jstaffel/tinyLoRaHW/README.md

# tinyLoRaHW
Hardware files of the tinyLoRa, a board that uses Rapsberry Pi's RP2040 microcontroller for LoRaWAN communication.
The board was designed in KiCad
