jstaffel/tinyLoRaHW/tinyLoRa/BOM_tinyLoRa_v1.01.xlsx

tinyLoRa |  |  | BOM |  |  | v1.01
 |  |  |  |  |  | 2022-06-06
RefDes | MPN | Geometry | Value | Qty | Description | Manufacturer
IC
U1 | MCP73831-5ACI_MC | - | - | 1 | Battery Management Li-Ion/Li-Poly Charg Mgnt 4.5V Vreg out | Microchip
U2 | SX1261IMLTRT | - | - | 1 | RF Transceiver LoRa, Low Power sub- GHz RF Transceiver | SEMTECH
U3 | AS213-92LF | - | - | 1 | SKYWORKS SOLUTIONS - AS213-92LF - IC, SWITCH, RF, SPDT, 0.1-3.0GHZ | Skyworks
U4 | AP2112M-3.3TRG1 | - | - | 1 | LDO Voltage Regulators LDO CMOS HiCurr | Diodes Inc.
U5 | W25Q128JVSIM | - | - | 1 | NOR-Flash spiFlash, 3V, 128M-bit, 4Kb Uniform Sector, DTR | Winbond
U6 | RPI Chip RP2040-7-500 | - | - | 1 | Dual ARM Cortex M0+ Microcontroller | Raspberry Pi
Resistors
R1 | - | 0603_1608 | 470 | 1 | - | -
R2 | - | 0603_1608 | 5k1 | 1 | - | -
R3 | - | 0603_1608 | 100 | 1 | - | -
R4 | CMP0603AFX-27R0ELF | 0603_1608 | 27 | 1 | Thick Film Resistors ResHighPowerA 0603 27R 1% 1/4W TC100 | Bourns
R5 | - | 0603_1608 | 10k | 1 | - | -
R6 | CMP0603AFX-27R0ELF | 0603_1608 | 27 | 1 | Thick Film Resistors ResHighPowerA 0603 27R 1% 1/4W TC100 | Bourns
R7 | - | 0603_1608 | 100 | 1 | - | -
R8 | - | 0603_1608 | DNP | 1 | - | -
R9 | - | 0603_1608 | DNP | 1 | - | -
R10 | - | 0603_1608 | 1k | 1 | - | -
R11 | ERJ-UP3F2000V | 0603_1608 | 200 | 1 | Thick Film Resistors 0603 0.25W 1% 200ohm AEC-Q200 | Panasonic
R12 | ERJ-U03F1R00V | 0603_1608 | 1 | 1 | Thick Film Resistors 0603 1% 1ohm AEC-Q200 Anti-Sulfur | Panasonic
R13 | - | 0603_1608 | 390 | 1 | - | -
R14 | - | 0603_1608 | 10k | 1 | - | -
R15 | - | 0603_1608 | DNP | 1 | - | -
R16 | - | 0603_1608 | 1k | 1 | - | -
Capacitors
C1 | - | 0603_1608 | DNP | 1 | - | -
C2 | - | 0603_1608 | DNP | 1 | - | -
C3 | ZRB18AR6YA475KE05L | 0603_1608 | 4u7 | 1 | Multilayer Ceramic Capacitors MLCC - SMD/SMT | Murata Electronics
C4 | ZRB18AR6YA475KE05L | 0603_1608 | 4u7 | 1 | Multilayer Ceramic Capacitors MLCC - SMD/SMT | Murata Electronics
C5 | - | 0603_1608 | 10n | 1 | - | -
C6 | GRM1555C1H3R0BA01D | 0402_1005 | 3p | 1 | Multilayer Ceramic Capacitors MLCC - SMD/SMT | Murata Electronics
C7 | - | 0603_1608 | 1n | 1 | - | -
C8 | - | 0603_1608 | 1u | 1 | - | -
C9 | GRM1555C1H120JA01J | 0402_1005 | 12p | 1 | Multilayer Ceramic Capacitors MLCC - SMD/SMT | Murata Electronics
C10 | UVK105CH2R2JW-F | 0402_1005 | 2p2 | 1 | Multilayer Ceramic Capacitors MLCC - SMD/SMT | Taiyo Yuden
C11 | GCJ188R71C474KA12D | 0603_1608 | 470n | 1 | Multilayer Ceramic Capacitors MLCC - SMD/SMT | Murata Electronics
C12 | GRM155C71H473JE19D | 0402_1005 | 47n | 1 | Multilayer Ceramic Capacitors MLCC - SMD/SMT | Murata Electronics
C13 | GCM1555C1H470JA16J | 0402_1005 | 47p | 1 | Multilayer Ceramic Capacitors MLCC - SMD/SMT | Murata Electronics
C14 | C0402C569J5GACTU | 0402_1005 | 5p6 | 1 | Multilayer Ceramic Capacitors MLCC - SMD/SMT | KEMET
C15 | - | 0603_1608 | 1u | 1 | - | -
C16 | GRM1555C1H1R8WA01D | 0402_1005 | 1p8 | 1 | Multilayer Ceramic Capacitors MLCC - SMD/SMT | Murata Electronics
C17 | - | 0603_1608 | 1u | 1 | - | -
C18 | GRM1555C1H1R0BA01D | 0402_1005 | 1p | 1 | Multilayer Ceramic Capacitors MLCC - SMD/SMT | Murata Electronics
C19 | - | 0603_1608 | 100n | 1 | - | -
C20 | GRM1555C1H1R8WA01D | 0402_1005 | 1p8 | 1 | Multilayer Ceramic Capacitors MLCC - SMD/SMT | Murata Electronics
C21 | - | 0603_1608 | 1n | 1 | - | -
C22 | GRM1555C1H220JA01D | 0402_1005 | 22p | 1 | Multilayer Ceramic Capacitors MLCC - SMD/SMT | Murata Electronics
C23 | - | 0603_1608 | 100n | 1 | - | -
C24 | UVK105CG3R3JW-F | 0402_1005 | 3p3 | 1 | Multilayer Ceramic Capacitors MLCC - SMD/SMT | Taiyo Yuden
C25 | UVK105CG3R3JW-F | 0402_1005 | 3p3 | 1 | Multilayer Ceramic Capacitors MLCC - SMD/SMT | Taiyo Yuden
C26 | CGA2B1X7R1C104K050BC | 0402_1005 | 100n | 1 | Multilayer Ceramic Capacitors MLCC - SMD/SMT CGA | TDK
C27 | C1005X5R1V225K050BE | 0402_1005 | 2u2 | 1 | Multilayer Ceramic Capacitors MLCC - SMD/SMT | TDK
C28 | CGA2B1X7R1C104K050BC | 0402_1005 | 100n | 1 | Multilayer Ceramic Capacitors MLCC - SMD/SMT CGA | TDK
C29 | CGA2B1X7R1C104K050BC | 0402_1005 | 100n | 1 | Multilayer Ceramic Capacitors MLCC - SMD/SMT CGA | TDK
C30 | CGA2B1X7R1C104K050BC | 0402_1005 | 100n | 1 | Multilayer Ceramic Capacitors MLCC - SMD/SMT CGA | TDK
C31 | C1005X5R1V225K050BE | 0402_1005 | 2u2 | 1 | Multilayer Ceramic Capacitors MLCC - SMD/SMT | TDK
C32 | C1005X5R1V225K050BE | 0402_1005 | 2u2 | 1 | Multilayer Ceramic Capacitors MLCC - SMD/SMT | TDK
C33 | CGA2B1X7R1C104K050BC | 0402_1005 | 100n | 1 | Multilayer Ceramic Capacitors MLCC - SMD/SMT CGA | TDK
C34 | CGA2B1X7R1C104K050BC | 0402_1005 | 100n | 1 | Multilayer Ceramic Capacitors MLCC - SMD/SMT CGA | TDK
C35 | CGA2B1X7R1C104K050BC | 0402_1005 | 100n | 1 | Multilayer Ceramic Capacitors MLCC - SMD/SMT CGA | TDK
C36 | CGA2B1X7R1C104K050BC | 0402_1005 | 100n | 1 | Multilayer Ceramic Capacitors MLCC - SMD/SMT CGA | TDK
C37 | - | 0603_1608 | 100n | 1 | - | -
C38 | GRM1885C2E270JW07D | 0603_1608 | 27p | 1 | Multilayer Ceramic Capacitors MLCC - SMD/SMT | Murata Electronics
C39 | GRM1885C2E270JW07D | 0603_1608 | 27p | 1 | Multilayer Ceramic Capacitors MLCC - SMD/SMT | Murata Electronics
Inductors
L1 | LQG15WZ47NH02D | 0402_1005 | 47n | 1 | Fixed Inductors Fixed IND 47nH 190mA | Murata Electronics
L2 | LQW15AN2N7C00D | 0402_1005 | 2n7 | 1 | Fixed Inductors 2.7 NH +-.2NH | Murata Electronics
L3 | LQP15MN9N1B02D | 0402_1005 | 9n1 | 1 | Fixed Inductors | Murata Electronics
L4 | LQG15WZ47NH02D | 0402_1005 | 47n | 1 | Fixed Inductors Fixed IND 47nH 190mA | Murata Electronics
L5 | LQM18DN150M70L | 0603_1608 | 15u | 1 | Fixed Inductors | Murata Electronics
L6 | LQW15AN18NH00D | 0402_1005 | 18n | 1 | Fixed Inductors 18 NH 3% | Murata Electronics
L7 | LQP15MN9N1B02D | 0402_1005 | 9n1 | 1 | Fixed Inductors | Murata Electronics
Diodes & LEDs
D1 | XZMDK53W-8 | 0603_1608 | LED Red | 1 | LED RED CLEAR CHIP SMD | SunLED
D2 | PMEG3050EP,115 | 2.7 x 4 mm | - | 1 | SMT Schottky Diode, 30V 5A, 2-Pin SOD-128 | Nexperia
D3 | PMEG3050EP,115 | 2.7 x 4 mm | - | 1 | SMT Schottky Diode, 30V 5A, 2-Pin SOD-128 | Nexperia
D4 | XZVG53W-8 | 0603_1608 | LED Green | 1 | LED GREEN CLEAR CHIP SMD | SunLED
Crystals
Y1 | LFXTAL060258Reel | 2.7 x 3.4 mm | 32.0 MHz | 1 | Crystals 32MHz 10pF -20C 70C | IQD
Y2 | 406I35D12M00000 | 3.5 x 6 mm | 12.0 MHz | 1 | Crystals 12MHz 30ppm 18pF -40C + 85C | CTS Electronic Components
Connectors, Buttons & other
AE1 | CONSMA020.042-G | 14.2 x 9.5 x 7.9 mm | - | 1 | RF Connectors SMA Connector Straight Jack (Female), PCB Edge Mount | Linx Technologies
J1 | USB4110-GF-A | 10.2 x 7.7 mm | USB-C | 1 | CONN USB 2.0 TYPE-C R/A SMT | GCT
J2 | 53261-0271 | 1.25 mm | 1X2 | 1 | Headers & Wire Housings 1.25MM HDR 2 CKT Right-Angle | Molex
J3 | - | 2.54 mm | 2x16 | 1 | Pin-Header male 2.54 mm | -
J4 | - | 2.54 mm | 1x3 | 1 | Pin-Header female 2.54 mm | -
JP1 | - | 2.54 mm | 1x2 | 1 | Pin-Header male 2.54 mm | -
U7 | - | 1.27 mm | 2x5 | 1 | Pin-Header male 1.27 mm | -
SW1 | 434123025826 | 2.8 x 5.2 mm | Bootsel | 1 | WS-TASV J-Bend SMT Tact Switch | Würth Elektronik
SW2 | 434123025826 | 2.8 x 5.2 mm | Reset | 1 | WS-TASV J-Bend SMT Tact Switch | Würth Elektronik
