jstaffel/tinyLoRaHW/tinyLoRa_v1.00/tinyLoRa.kicad_pcb

## KiCad design tinyLoRa_v1.00/tinyLoRa.kicad_pcb (2022-07-30)

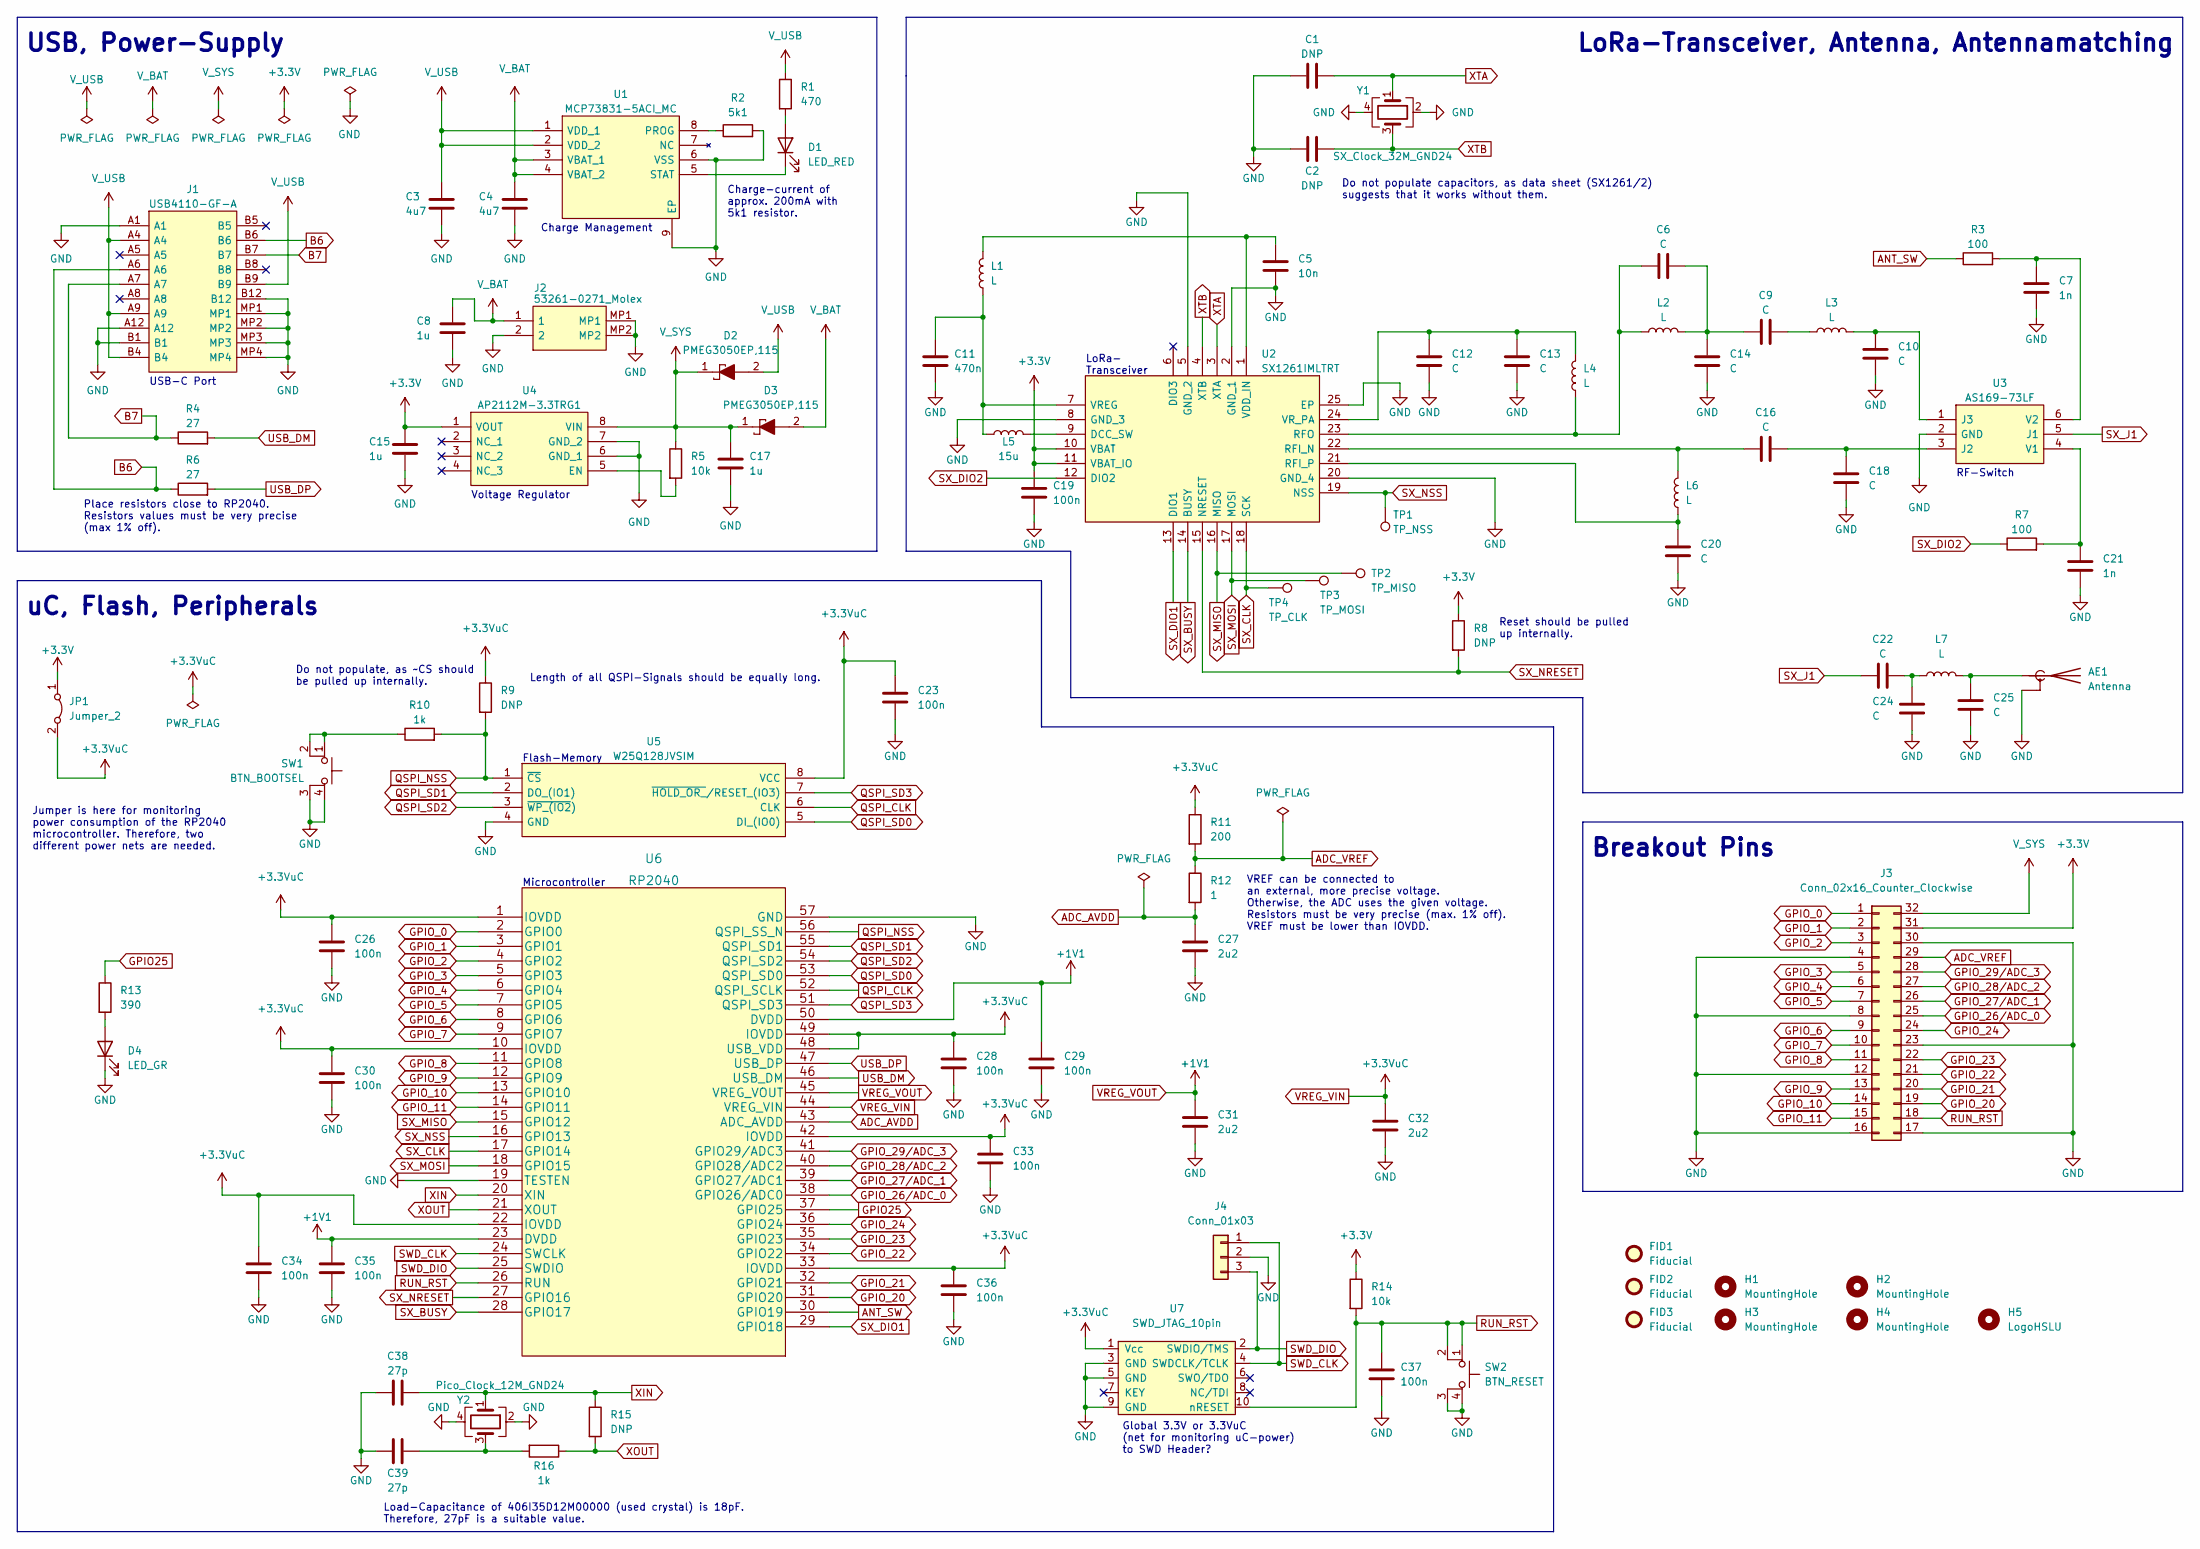
[picture p1: schematic tinyLoRa.kicad_sch]

Parts:
AE1: Antenna; antenna_connector
C1, C2: DNP; R_0603_1608Metric
C3, C4: 4u7; R_0603_1608Metric
C5: 10n; R_0603_1608Metric
C6, C9, C10, C12, C13, C14, C16, C18, C20, C22, C24, C25: C; R_0402_1005Metric
C7, C21: 1n; R_0603_1608Metric
C8, C15, C17: 1u; R_0603_1608Metric
C11: 470n; R_0603_1608Metric
C19, C23, C37: 100n; R_0603_1608Metric
C26, C28, C29, C30, C33, C34, C35, C36: 100n; R_0402_1005Metric
C27, C31, C32: 2u2; R_0402_1005Metric
C38, C39: 27p; R_0603_1608Metric
D1: LED_RED; R_0603_1608Metric
D2, D3: PMEG3050EP,115; PMEG3050EP115; Mouser Part Number 771-PMEG3050EP115
D4: LED_GR; R_0603_1608Metric
FID1, FID2, FID3: Fiducial; Fiducial_1mm_Dia_2.54mm_Outer_CopperTop
H1, H2, H3, H4: MountingHole; MountingHole_2.7mm_M2.5_LargeMask
H5: LogoHSLU; hslu_logo_new
J1: USB4110-GF-A; USB4110GFA; Mouser Part Number 640-USB4110-GF-A
J2: 53261-0271_Molex; 532610271_Molex; Mouser Part Number 538-53261-0271
J3: Conn_02x16_Counter_Clockwise; PinHeader_tinyLoRa
J4: Conn_01x03; PinSocket_1x03_P2.54mm_Vertical
JP1: Jumper_2; PinSocket_1x02_P2.54mm_Vertical
L1: L; R_0603_1608Metric
L2, L3, L4, L6, L7: L; R_0402_1005Metric
L5: 15u; R_0603_1608Metric
R1: 470; R_0603_1608Metric
R2: 5k1; R_0603_1608Metric
R3, R7: 100; R_0603_1608Metric
R4, R6: 27; R_0603_1608Metric
R5, R14: 10k; R_0603_1608Metric
R8, R9, R15: DNP; R_0603_1608Metric
R10, R16: 1k; R_0603_1608Metric
R11: 200; R_0603_1608Metric
R12: 1; R_0603_1608Metric
R13: 390; R_0603_1608Metric
SW1: BTN_BOOTSEL; 434123025826_BTN
SW2: BTN_RESET; 434123025826_BTN
TP1: TP_NSS; TestPoint_Pad_D1.0mm
TP2: TP_MISO; TestPoint_Pad_D1.0mm
TP3: TP_MOSI; TestPoint_Pad_D1.0mm
TP4: TP_CLK; TestPoint_Pad_D1.0mm
U1: MCP73831-5ACI_MC; SON50P300X200X100-9N-D; Mouser Part Number 579-MCP73831-5ACI/MC
U2: SX1261IMLTRT; QFN50P400X400X100-25N-D; Mouser Part Number 947-SX1261IMLTRT
U3: AS169-73LF; SOT95P270X145-6N; Mouser Part Number 873-AS169-73LF
U4: AP2112M-3.3TRG1; SOIC127P600X170-8N; Mouser Part Number 621-AP2112M-3.3TRG1
U5: W25Q128JVSIM; SOIC127P790X216-8N; Mouser Part Number 454-W25Q128JVSIM
U6: RP2040
U7: SWD_JTAG_10pin; SWD_Pin_Header_Straight_2x05_Pitch1.27mm
Y1: SX_Clock_32M_GND24; SX_Clock_GND24
Y2: Pico_Clock_12M_GND24; Pico_Clock_GND24

Connections:
+3V3: C15.1, C19.1, J3.31, JP1.1 (A), R8.1, R14.1, U2.10 (VBAT), U2.11 (VBAT_IO), U4.1 (VOUT)
ADC_AVDD: C27.1, R12.2, U6.43 (ADC_AVDD)
ADC_VREF: J3.29, R11.2, R12.1
ANT_SW: R3.1, U6.30 (GPIO19)
B6: J1.A6, J1.B6, R6.1
B7: J1.A7, J1.B7, R4.1
GND: AE1.2 (Shield), C1.1, C2.1, C3.2, C4.2, C5.2, C7.2, C8.2, C10.2, C11.2, C12.2, C13.2, C14.2, C15.2, C17.2, C18.2, C19.2, C20.2, C21.2, C23.2, C24.1, C25.1, C26.2, C27.2, C28.2, C29.2, C30.2, C31.2, C32.2, C33.2, C34.2, C35.2, C36.2, C37.2, C38.1, C39.1, D4.1 (K), J1.A1, J1.A12, J1.B1, J1.B12, J1.MP1, J1.MP2, J1.MP3, J1.MP4, J2.2, J2.MP1, J2.MP2, J3.4, J3.8, J3.12, J3.16, J3.17, J3.23, J3.30, J4.2, R2.2, SW1.3 (K), SW1.4 (A), SW2.3 (K), SW2.4 (A), U1.6 (VSS), U1.9 (EP), U2.2 (GND_1), U2.5 (GND_2), U2.8 (GND_3), U2.20 (GND_4), U2.25 (EP), U3.2 (GND), U4.6 (GND_1), U4.7 (GND_2), U5.4 (GND), U6.19 (TESTEN), U6.57 (GND), U7.3 (GND), U7.5 (GND), U7.9 (GND), Y1.2, Y1.4, Y2.2, Y2.4; also elsewhere on the board
GPIO25: R13.1, U6.37 (GPIO25)
GPIO_0: J3.1, U6.2 (GPIO0)
GPIO_1: J3.2, U6.3 (GPIO1)
GPIO_2: J3.3, U6.4 (GPIO2)
GPIO_3: J3.5, U6.5 (GPIO3)
GPIO_4: J3.6, U6.6 (GPIO4)
GPIO_5: J3.7, U6.7 (GPIO5)
GPIO_6: J3.9, U6.8 (GPIO6)
GPIO_7: J3.10, U6.9 (GPIO7)
GPIO_8: J3.11, U6.11 (GPIO8)
GPIO_9: J3.13, U6.12 (GPIO9)
GPIO_10: J3.14, U6.13 (GPIO10)
GPIO_11: J3.15, U6.14 (GPIO11)
GPIO_20: J3.19, U6.31 (GPIO20)
GPIO_21: J3.20, U6.32 (GPIO21)
GPIO_22: J3.21, U6.34 (GPIO22)
GPIO_23: J3.22, U6.35 (GPIO23)
GPIO_24: J3.24, U6.36 (GPIO24)
GPIO_26/ADC_0: J3.25, U6.38 (GPIO26/ADC0)
GPIO_27/ADC_1: J3.26, U6.39 (GPIO27/ADC1)
GPIO_28/ADC_2: J3.27, U6.40 (GPIO28/ADC2)
GPIO_29/ADC_3: J3.28, U6.41 (GPIO29/ADC3)
unnamed: AE1.1 (A), C25.2, L7.2
unnamed: C5.1, L1.2, U2.1 (VDD_IN)
unnamed: C6.1, L2.1, L4.1, U2.23 (RFO)
unnamed: C7.1, R3.2, U3.6 (V2)
unnamed: C9.2, L3.1
unnamed: C10.1, L3.2, U3.1 (J3)
unnamed: C11.1, L1.1, L5.1, U2.7 (VREG)
unnamed: C12.1, C13.1, L4.2, U2.24 (VR_PA)
unnamed: C6.2, C9.1, C14.1, L2.2
unnamed: C16.1, L6.2, U2.22 (RFI_N)
unnamed: C16.2, C18.1, U3.3 (J2)
unnamed: C20.1, L6.1, U2.21 (RFI_P)
unnamed: C21.1, R7.2, U3.4 (V1)
unnamed: C22.2, C24.2, L7.1
unnamed: C39.2, R16.2, Y2.3
unnamed 44: D1.1 (K), U1.5 (STAT); also elsewhere on the board
unnamed 45: D1.2 (A), R1.2; also elsewhere on the board
unnamed: D4.2 (A), R13.2
unnamed: L5.2, U2.9 (DCC_SW)
unnamed: R2.1, U1.8 (PROG)
unnamed: R5.2, U4.5 (EN)
unnamed 50: R10.1, SW1.1, SW1.2; also elsewhere on the board
QSPI_CLK: U5.6 (CLK), U6.52 (QSPI_SCLK)
QSPI_NSS: R9.2, R10.2, U5.1 (~CS), U6.56 (QSPI_SS_N)
QSPI_SD0: U5.5 (DI_(IO0)), U6.53 (QSPI_SD0)
QSPI_SD1: U5.2 (DO_(IO1)), U6.55 (QSPI_SD1)
QSPI_SD2: U5.3 (~WP_(IO2)), U6.54 (QSPI_SD2)
QSPI_SD3: U5.7 (~HOLD_OR_/RESET_(IO3)), U6.51 (QSPI_SD3)
RUN_RST: C37.1, J3.18, R14.2, SW2.1, SW2.2, U6.26 (RUN), U7.10 (nRESET); also elsewhere on the board
SWD_CLK: J4.1, U6.24 (SWCLK), U7.4 (SWDCLK/TCLK)
SWD_DIO: J4.3, U6.25 (SWDIO), U7.2 (SWDIO/TMS)
SX_BUSY: U2.14 (BUSY), U6.28 (GPIO17)
SX_CLK: TP4.1, U2.18 (SCK), U6.17 (GPIO14)
SX_DIO1: U2.13 (DIO1), U6.29 (GPIO18)
SX_DIO2: R7.1, U2.12 (DIO2)
SX_J1: C22.1, U3.5 (J1)
SX_MISO: TP2.1, U2.16 (MISO), U6.15 (GPIO12)
SX_MOSI: TP3.1, U2.17 (MOSI), U6.18 (GPIO15)
SX_NRESET: R8.2, U2.15 (NRESET), U6.27 (GPIO16)
SX_NSS: TP1.1, U2.19 (NSS), U6.16 (GPIO13)
USB_DM: R4.2, U6.46 (USB_DM)
USB_DP: R6.2, U6.47 (USB_DP)
VREG_VIN: C23.1, C26.1, C28.1, C30.1, C32.1, C33.1, C34.1, C36.1, JP1.2 (B), R9.1, R11.1, U5.8 (VCC), U6.1 (IOVDD), U6.10 (IOVDD), U6.22 (IOVDD), U6.33 (IOVDD), U6.42 (IOVDD), U6.44 (VREG_VIN), U6.48 (USB_VDD), U6.49 (IOVDD), U7.1 (Vcc)
VREG_VOUT: C29.1, C31.1, C35.1, U6.23 (DVDD), U6.45 (VREG_VOUT), U6.50 (DVDD)
V_BAT: C4.1, C8.1, D3.2, J2.1, U1.3 (VBAT_1), U1.4 (VBAT_2)
V_SUB: C3.1, D2.2, J1.A4, J1.A9, J1.B4, J1.B9, R1.1, U1.1 (VDD_1), U1.2 (VDD_2)
V_SYS: C17.1, D2.1, D3.1, J3.32, R5.1, U4.8 (VIN)
XIN: C38.2, R15.1, U6.20 (XIN), Y2.1
XOUT: R15.2, R16.1, U6.21 (XOUT)
XTA: C1.2, U2.3 (XTA), Y1.1
XTB: C2.2, U2.4 (XTB), Y1.3

Notes on the sheet:
RF-Switch
LoRa-Transceiver, Antenna, Antennamatching
LoRa- Transceiver
USB-C Port
Global 3.3V or 3.3VuC (net for monitoring uC-power) to SWD Header?
Do not populate, as ~CS should be pulled up internally.
Length of all QSPI-Signals should be equally long.
Charge-current of approx. 200mA with 5k1 resistor.
Do not populate capacitors, as data sheet (SX1261/2) suggests that it works without them.
Voltage Regulator
USB, Power-Supply
Charge Management
Load-Capacitance of 406I35D12M00000 (used crystal) is 18pF. Therefore, 27pF is a suitable value.
Jumper is here for monitoring power consumption of the RP2040 microcontroller. Therefore, two different power nets are needed.
uC, Flash, Peripherals
VREF can be connected to an external, more precise voltage. Otherwise, the ADC uses the given voltage. Resistors must be very precise (max. 1% off). VREF must be lower than IOVDD.
Place resistors close to RP2040. Resistors values must be very precise (max 1% off).
Microcontroller
Flash-Memory
Reset should be pulled up internally.
Breakout Pins

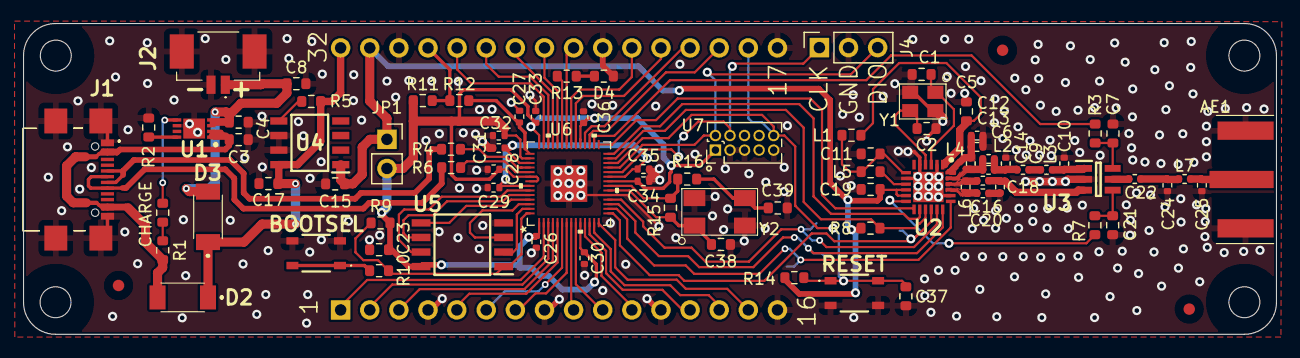
[picture p2: board tinyLoRa.kicad_pcb from above]

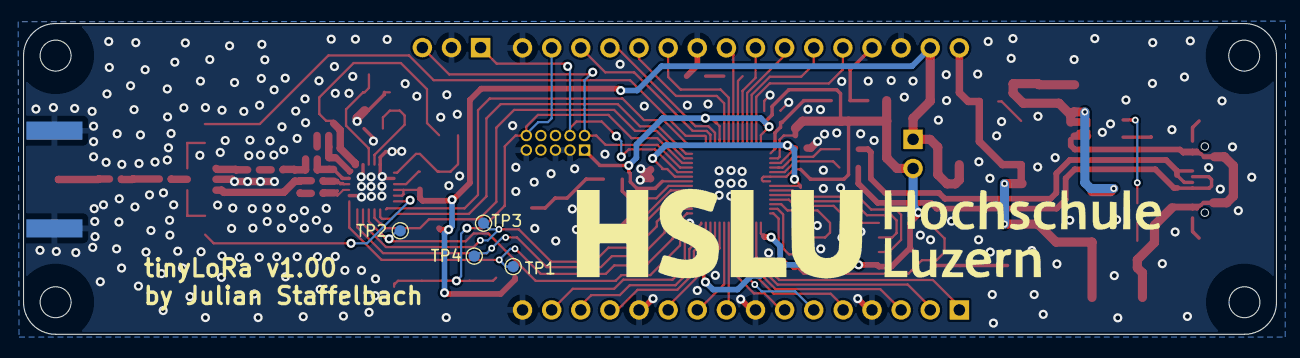
[picture p3: board tinyLoRa.kicad_pcb from below]

Board: 2 copper layers, 109.3 x 27.1 mm, 95 parts (5 on the bottom side), 80 nets.

Other parts of the board:
BOOTSEL: BTN_BOOTSEL; 434123025826_BTN
CHARGE: LED_RED; R_0603_1608Metric
RESET: BTN_RESET; 434123025826_BTN

Their connections:
GND: BOOTSEL.3 (K), BOOTSEL.4 (A), RESET.3 (K), RESET.4 (A); also elsewhere on the board
unnamed 44: CHARGE.1 (K); also elsewhere on the board
unnamed 45: CHARGE.2 (A); also elsewhere on the board
unnamed 50: BOOTSEL.1, BOOTSEL.2; also elsewhere on the board
RUN_RST: RESET.1, RESET.2; also elsewhere on the board
